is-buiquocdoanh/Temperature-and-humidity-sensor-network/Image/gate_way_sofware.png

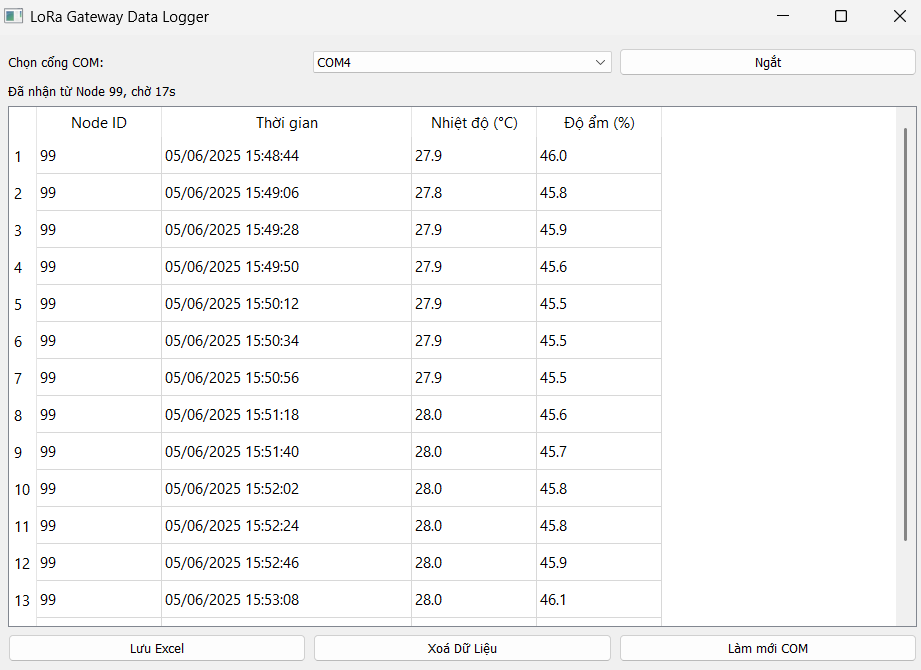
Image/gate_way_sofware.png
