is-buiquocdoanh/Temperature-and-humidity-sensor-network/Image/Hardware.jpg

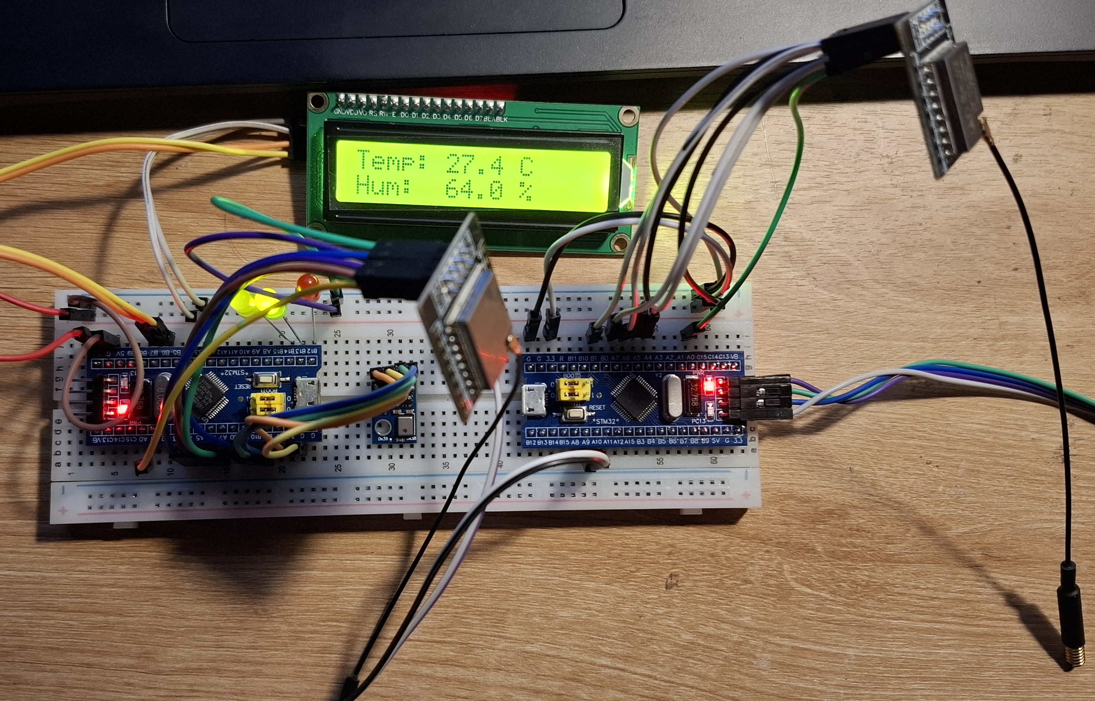
Image/Hardware.jpg
