is-buiquocdoanh/Temperature-and-humidity-sensor-network/PCB/NodeLORA/PDF/BOM NodeLORA.pdf

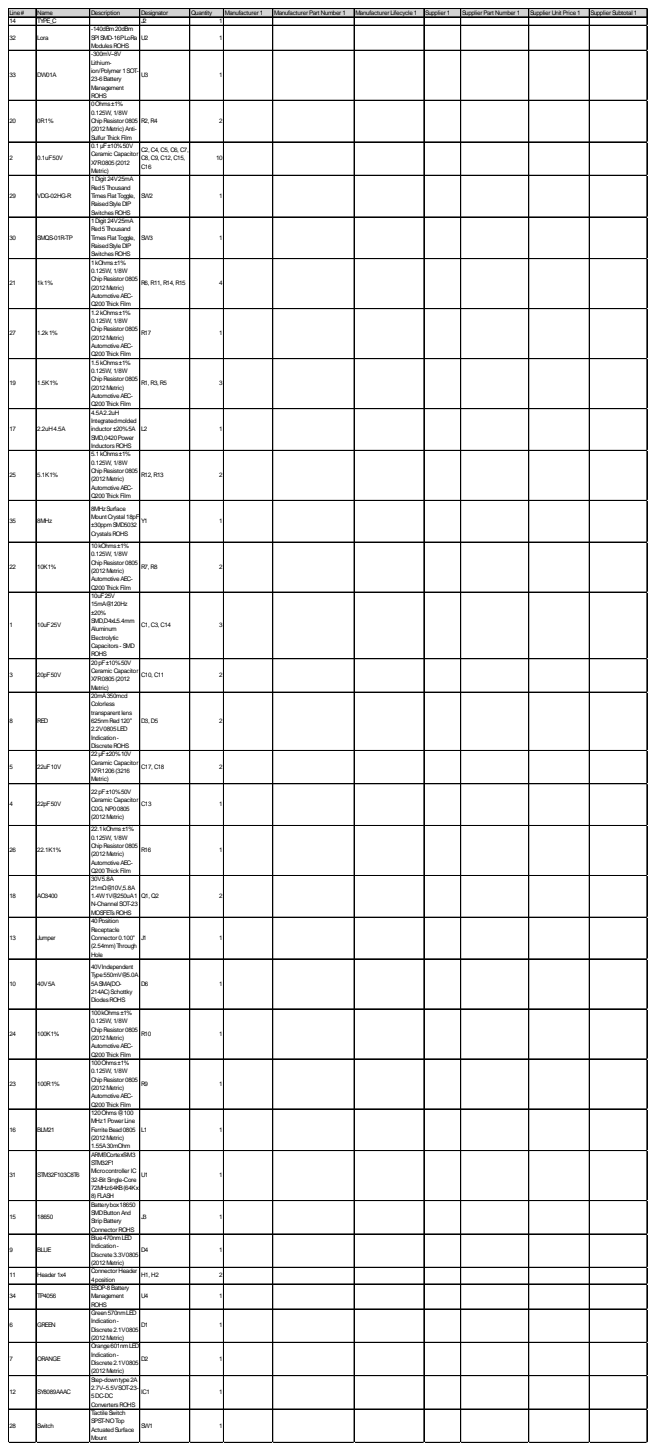
[picture p8: page 1]

32 | Lora | -140dBm20dBm SPISMD-16PLoRa ModulesROHS | U2 | | 1

33 | DW01A | -300mV~8V Lithium-ion/Polymer 1SOT-23-6Battery Management ROHS | U3 | | 1

20 | 0R1% | 0Ohms±1% 0.125W, 1/8W ChipResistor 0805 (2012Metric)Anti-Sulfur ThickFilm | R2, R4 | | 2

2 | 0.1uF50V | 0.1µF±10%50V Ceramic Capacitor X7R0805(2012 Metric) | C2, C4, C5, C6, C7, C8, C9, C12, C15, C16 | 10

29 | VDG-02HG-R | 1Digit 24V25mA Red5Thousand TimesFlat Toggle, RaisedStyleDIP SwitchesROHS | SW2 | | 1

30 | SMQS-01R-TP | 1Digit 24V25mA Red5Thousand TimesFlat Toggle, RaisedStyleDIP SwitchesROHS | SW3 | | 1

21 | 1k1% | 1kOhms±1% 0.125W, 1/8W ChipResistor 0805 (2012Metric) AutomotiveAEC-Q200ThickFilm | R6, R11, R14, R15 | | 4

27 | 1.2k1% | 1.2kOhms±1% 0.125W, 1/8W ChipResistor 0805 (2012Metric) AutomotiveAEC-Q200ThickFilm | R17 | | 1

19 | 1.5K1% | 1.5kOhms±1% 0.125W, 1/8W ChipResistor 0805 (2012Metric) AutomotiveAEC-Q200ThickFilm | R1, R3, R5 | | 3

17 | 2.2uH4.5A | 4.5A2.2uH Integratedmolded inductor ±20%5A SMD,0420Power InductorsROHS | L2 | | 1

25 | 5.1K1% | 5.1kOhms±1% 0.125W, 1/8W ChipResistor 0805 (2012Metric) AutomotiveAEC-Q200ThickFilm | R12, R13 | | 2

35 | 8MHz | 8MHzSurface Mount Crystal 18pF ±30ppmSMD5032 CrystalsROHS | Y1 | | 1

22 | 10K1% | 10kOhms±1% 0.125W, 1/8W ChipResistor 0805 (2012Metric) AutomotiveAEC-Q200ThickFilm | R7, R8 | | 2

1 | 10uF25V | 10uF25V 15mA@120Hz ±20% SMD,D4xL5.4mm Aluminum Electrolytic Capacitors - SMD ROHS | C1, C3, C14 | | 3

3 | 20pF50V | 20pF±10%50V Ceramic Capacitor X7R0805(2012 Metric) | C10, C11 | | 2

8 | RED | 20mA350mcd Colorless transparent lens 625nmRed120° 2.2V0805LED Indication-DiscreteROHS | D3, D5 | | 2

5 | 22uF10V | 22µF±20%10V Ceramic Capacitor X7R1206(3216 Metric) | C17, C18 | | 2

4 | 22pF50V | 22pF±10%50V Ceramic Capacitor C0G, NP00805 (2012Metric) | C13 | | 1

26 | 22.1K1% | 22.1kOhms±1% 0.125W, 1/8W ChipResistor 0805 (2012Metric) AutomotiveAEC-Q200ThickFilm | R16 | | 1

18 | AO3400 | 30V5.8A 21mΩ@10V,5.8A 1.4W1V@250uA1 N-Channel SOT-23 MOSFETsROHS | Q1, Q2 | | 2

13 | Jumper | 40Position Receptacle Connector 0.100" (2.54mm)Through Hole | J1 | | 1

10 | 40V5A | 40VIndependent Type550mV@5.0A 5ASMA(DO-214AC)Schottky DiodesROHS | D6 | | 1

24 | 100K1% | 100kOhms±1% 0.125W, 1/8W ChipResistor 0805 (2012Metric) AutomotiveAEC-Q200ThickFilm | R10 | | 1

23 | 100R1% | 100Ohms±1% 0.125W, 1/8W ChipResistor 0805 (2012Metric) AutomotiveAEC-Q200ThickFilm | R9 | | 1

16 | BLM21 | 120Ohms@100 MHz1Power Line FerriteBead0805 (2012Metric) 1.55A30mOhm | L1 | | 1

31 | STM32F103C8T6 | ARM®Cortex®-M3 STM32F1 Microcontroller IC 32-Bit Single-Core 72MHz64KB(64Kx 8)FLASH | U1 | | 1

15 | 18650 | Batterybox18650 SMDButtonAnd StripBattery Connector ROHS | J3 | | 1

9 | BLUE | Blue470nmLED Indication-Discrete3.3V0805 (2012Metric) | D4 | | 1

11 | Header 1x4 | Connector Header 4position | H1, H2 | | 2

34 | TP4056 | ESOP-8Battery Management ROHS | U4 | | 1

6 | GREEN | Green570nmLED Indication-Discrete2.1V0805 (2012Metric) | D1 | | 1

7 | ORANGE | Orange601nmLED Indication-Discrete2.1V0805 (2012Metric) | D2 | | 1

12 | SY8089AAAC | Step-downtype2A 2.7V~5.5VSOT-23-5DC-DC ConvertersROHS | IC1 | | 1

28 | Switch | TactileSwitch SPST-NOTop ActuatedSurface Mount | SW1 | | 1
