is-buiquocdoanh/Temperature-and-humidity-sensor-network/PCB/SCH-NodeLORA.pdf

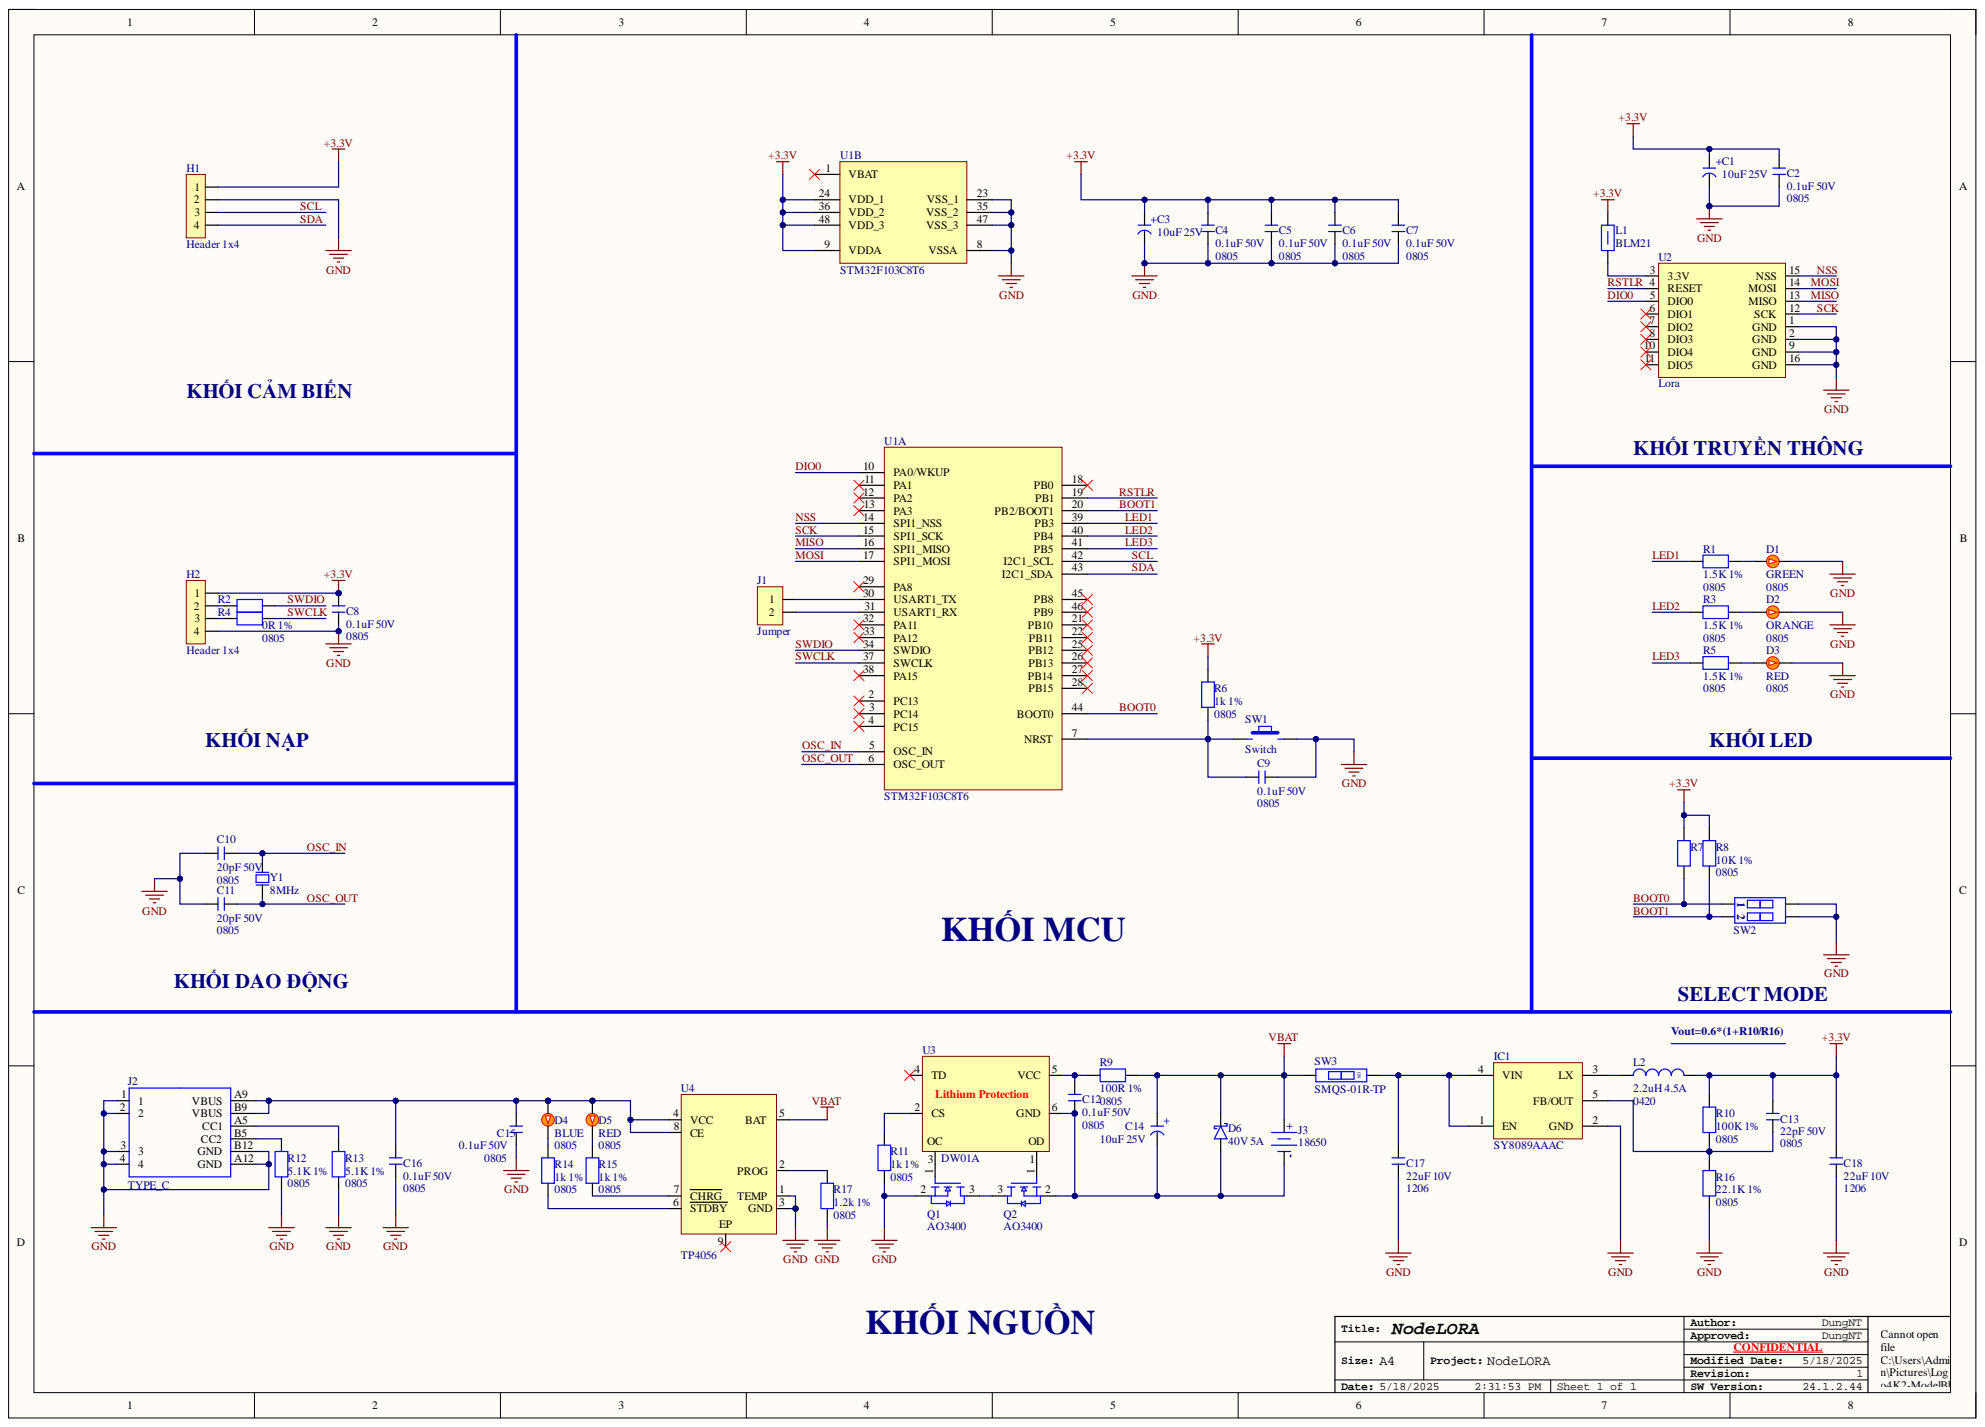
[picture p9: page 1]
