is-buiquocdoanh/Temperature-and-humidity-sensor-network/PCB/NodeLORA/PDF/PCB NodeLORA.pdf

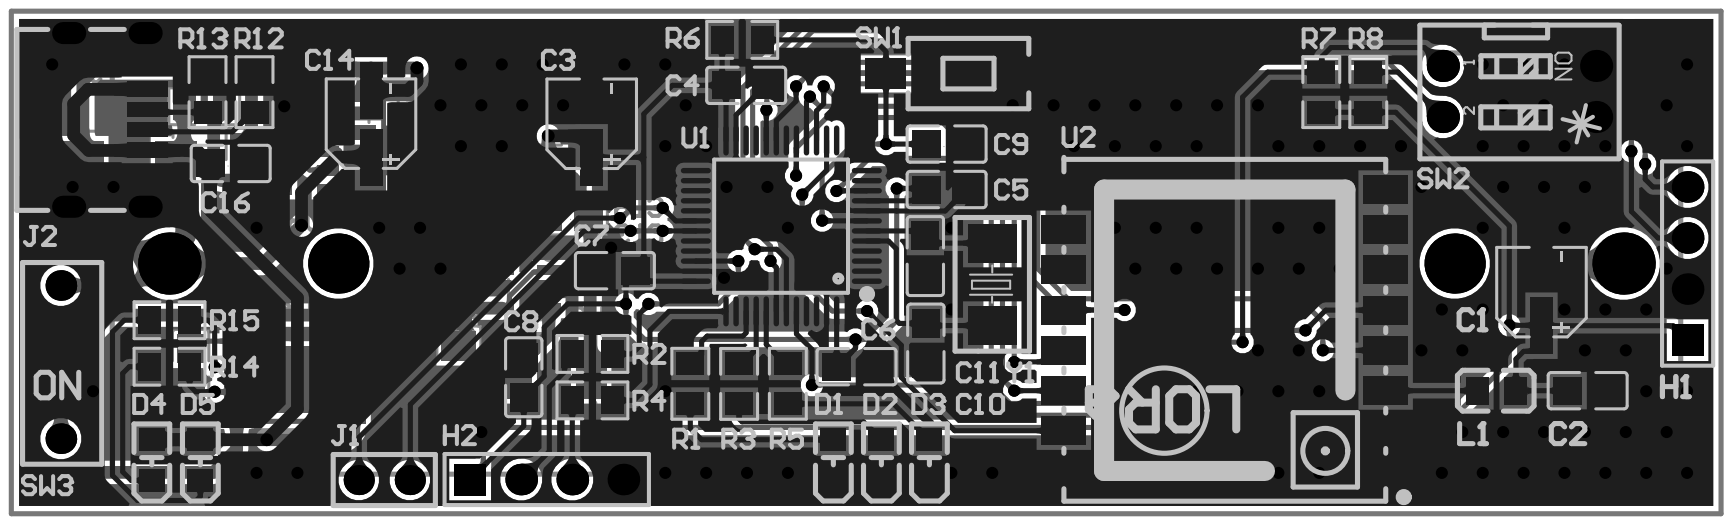
[picture p10: page 1]
