is-buiquocdoanh/Temperature-and-humidity-sensor-network/(list of files, drawings)

Other design files:
PCB/NodeLORA/NodeLORA.PrjPcb
PCB/NodeLORA/NodeLORA.SchDoc
