is-buiquocdoanh/Temperature-and-humidity-sensor-network/Node_LoRa/Core/Src/main.c

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
/* Includes ------------------------------------------------------------------*/
#include "main.h"

/* USER CODE BEGIN Includes */
#include "string.h"
#include "stdio.h"
#include "stdlib.h"
#include "i2c_lcd.h"
#include "aht10.h"
#include "LoRa.h"
/* USER CODE END Includes */

I2C_HandleTypeDef hi2c1;
I2C_HandleTypeDef hi2c2;

SPI_HandleTypeDef hspi1;

TIM_HandleTypeDef htim2;

UART_HandleTypeDef huart1;

/* USER CODE BEGIN PV */
AHT10_HandleTypeDef aht10;
I2C_LCD_HandleTypeDef lcd;

LoRa myLoRa;

char debug[32];
char buffer[32];
float temperature, humidity;
uint32_t temp_raw = 0;
uint32_t hum_raw = 0;

//Biến cấu hình ngưỡng và chu kỳ
float temp_max = 30.0;
float temp_min = 25.0;
float humi_max = 70.0;
float humi_min = 40.0;
uint32_t interval_ms = 1000;  // mặc định 1 giây

uint8_t uart_rx_buf[64];
char uart_line[64];
uint8_t uart_index = 0;

/* USER CODE END PV */

void SystemClock_Config(void);
static void MX_GPIO_Init(void);
static void MX_I2C1_Init(void);
static void MX_I2C2_Init(void);
static void MX_SPI1_Init(void);
static void MX_USART1_UART_Init(void);
static void MX_TIM2_Init(void);
/* USER CODE BEGIN PFP */

// Phân tích lệnh từ UART
void parse_uart_command(char *cmd) {
    if (strncmp(cmd, "SET:", 4) == 0) {
        char *token = strtok(cmd + 4, ":");
        while (token != NULL) {
            if (strncmp(token, "TMAX=", 5) == 0) temp_max = atof(token + 5);
            else if (strncmp(token, "TMIN=", 5) == 0) temp_min = atof(token + 5);
            else if (strncmp(token, "HMAX=", 5) == 0) humi_max = atof(token + 5);
            else if (strncmp(token, "HMIN=", 5) == 0) humi_min = atof(token + 5);
            else if (strncmp(token, "INTERVAL=", 9) == 0) interval_ms = atoi(token + 9) * 1000;
            token = strtok(NULL, ":");
        }
        HAL_UART_Transmit(&huart1, (uint8_t*)"Config Updated\r\n", 16, HAL_MAX_DELAY);
    }
}

/* Ngắt USART1 xử lý ngay trong main.c */
void HAL_UART_RxCpltCallback(UART_HandleTypeDef *huart) {
    if (huart->Instance == USART1) {
        char ch = uart_rx_buf[0];

        if (ch == '\n' || ch == '\r') {
            uart_line[uart_index] = '\0';  // kết thúc chuỗi

            HAL_UART_Transmit(&huart1, (uint8_t*)"Received: ", 10, HAL_MAX_DELAY);
            HAL_UART_Transmit(&huart1, (uint8_t*)uart_line, strlen(uart_line), HAL_MAX_DELAY);
            HAL_UART_Transmit(&huart1, (uint8_t*)"\r\n", 2, HAL_MAX_DELAY);

            parse_uart_command(uart_line);  // xử lý lệnh
            uart_index = 0;
            memset(uart_line, 0, sizeof(uart_line));
        } else {
            if (uart_index < sizeof(uart_line) - 1) {
                uart_line[uart_index++] = ch;
            }
        }

        // nhận tiếp 1 byte
        HAL_UART_Receive_IT(&huart1, uart_rx_buf, 1);
    }
}


/* USER CODE END PFP */

/**
  * @brief  The application entry point.
  * @retval int
  */
int main(void)
{

  /* MCU Configuration--------------------------------------------------------*/

  /* Reset of all peripherals, Initializes the Flash interface and the Systick. */
  HAL_Init();

  /* Configure the system clock */
  SystemClock_Config();

  /* Initialize all configured peripherals */
  MX_GPIO_Init();
  MX_I2C1_Init();
  MX_I2C2_Init();
  MX_SPI1_Init();
  MX_USART1_UART_Init();
  MX_TIM2_Init();
  /* USER CODE BEGIN 2 */

  // Bật Timer với ngắt
  HAL_TIM_Base_Start_IT(&htim2);

  //Bật receive uart
  HAL_UART_Receive_IT(&huart1, uart_rx_buf, 1);  // khởi động nhận từng byte

  //Init LCD
  lcd.hi2c = &hi2c1;
  lcd.address = 0x4E;
  lcd_init(&lcd);
  lcd_clear(&lcd);

  //Init AHT10
  aht10.hi2c = &hi2c2;
  aht10.address = 0x38<<1; //AHT10 default address << 1 = 0x38 << 1 = 0x70
  AHT10_Init(&aht10);
  HAL_Delay(50);

  //Init LoRa
  myLoRa = newLoRa();

  myLoRa.CS_port         = NSS_GPIO_Port;
  myLoRa.CS_pin          = NSS_Pin;
  myLoRa.reset_port      = RST_GPIO_Port;
  myLoRa.reset_pin       = RST_Pin;
  myLoRa.DIO0_port       = DIO0_GPIO_Port;
  myLoRa.DIO0_pin        = DIO0_Pin;
  myLoRa.hSPIx           = &hspi1;

  LoRa_init(&myLoRa);

    if (!LoRa_init(&myLoRa)) {
        HAL_UART_Transmit(&huart1, (uint8_t*)"LoRa init failed\r\n", 18, 100);
    }
    else {
    	HAL_UART_Transmit(&huart1, (uint8_t*)"LoRa init done\r\n", 14, 100);
    }

  /* USER CODE END 2 */

  /* Infinite loop */
  /* USER CODE BEGIN WHILE */
  while (1)
  {
		//Read sensor AHT10
		if (AHT10_ReadRaw(&aht10, &hum_raw, &temp_raw)) {
			temperature = AHT10_ReadTemperature(temp_raw);
			humidity = AHT10_ReadHumidity(hum_raw);

			int temp_int = (int) temperature;
			int temp_frac = (int) ((temperature - temp_int) * 10);

			int hum_int = (int) humidity;
			int hum_frac = (int) ((humidity - hum_int) * 10);

			//Send data via UART & LoRa
			uint8_t node_id = 01;
			sprintf(buffer, "NODE%d:%d.%d:%d.%d\r\n", node_id, temp_int,
					temp_frac, hum_int, hum_frac);
			HAL_UART_Transmit(&huart1, (uint8_t*) buffer, strlen(buffer),
			HAL_MAX_DELAY);

			if (!LoRa_transmit(&myLoRa, (uint8_t*) buffer, strlen(buffer),
					100)) {
				HAL_UART_Transmit(&huart1, (uint8_t*) "LoRa Send Error\r\n", 17,
				HAL_MAX_DELAY);
			}

			// LED theo nhiệt độ
			HAL_GPIO_WritePin(GPIOB, GPIO_PIN_12, GPIO_PIN_RESET);
			HAL_GPIO_WritePin(GPIOB, GPIO_PIN_13, GPIO_PIN_RESET);
			HAL_GPIO_WritePin(GPIOB, GPIO_PIN_14, GPIO_PIN_RESET);

			GPIO_TypeDef *ledPort = GPIOB;
			uint16_t ledPin;
			if (temperature > temp_max) {
				ledPin = GPIO_PIN_12; // đỏ
			} else if (temperature >= temp_min) {
				ledPin = GPIO_PIN_13; // vàng
			} else {
				ledPin = GPIO_PIN_14; // xanh
			}

			uint32_t displayTime = 2000;
			uint32_t startTime = HAL_GetTick();
			while ((HAL_GetTick() - startTime) < displayTime) {
				if (humidity >= humi_min && humidity <= humi_max) {
					HAL_GPIO_WritePin(ledPort, ledPin, GPIO_PIN_SET);
				} else if (humidity < humi_min) {
					HAL_GPIO_WritePin(ledPort, ledPin, GPIO_PIN_SET);
					HAL_Delay(100);
					HAL_GPIO_WritePin(ledPort, ledPin, GPIO_PIN_RESET);
					HAL_Delay(100);
				} else {
					HAL_GPIO_WritePin(ledPort, ledPin, GPIO_PIN_SET);
					HAL_Delay(500);
					HAL_GPIO_WritePin(ledPort, ledPin, GPIO_PIN_RESET);
					HAL_Delay(500);
				}
			}

			//Display on LCD
			sprintf(buffer, "Temp: %d.%d C", temp_int, temp_frac);
			lcd_gotoxy(&lcd, 0, 0);
			lcd_puts(&lcd, buffer);

			sprintf(buffer, "Hum:  %d.%d %%", hum_int, hum_frac);
			lcd_gotoxy(&lcd, 0, 1);
			lcd_puts(&lcd, buffer);
		} else {
			lcd_gotoxy(&lcd, 0, 0);
			HAL_UART_Transmit(&huart1, (uint8_t*) "AHT10 Error\r\n", 13,
					HAL_MAX_DELAY);
		}

		// Delay theo chu kỳ
		HAL_Delay(interval_ms);

//	  // ---- CHẾ ĐỘ SLEEP ----
//	  HAL_SuspendTick();  // Ngừng SysTick để không tự wake up
//	  HAL_PWR_EnterSLEEPMode(PWR_MAINREGULATOR_ON, PWR_SLEEPENTRY_WFI);
//	  HAL_ResumeTick();   // Khi wake up xong, bật lại SysTick;


    /* USER CODE END WHILE */

    /* USER CODE BEGIN 3 */
  }
  /* USER CODE END 3 */
}

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
