is-buiquocdoanh/Temperature-and-humidity-sensor-network/Node_LoRa/Core/Inc/main.h

#define DIO0_Pin GPIO_PIN_0
#define DIO0_GPIO_Port GPIOA
#define NSS_Pin GPIO_PIN_4
#define NSS_GPIO_Port GPIOA
#define RST_Pin GPIO_PIN_1
#define RST_GPIO_Port GPIOB
#define LED1_Pin GPIO_PIN_12
#define LED1_GPIO_Port GPIOB
#define LED2_Pin GPIO_PIN_13
#define LED2_GPIO_Port GPIOB
#define LED3_Pin GPIO_PIN_14
#define LED3_GPIO_Port GPIOB
