is-buiquocdoanh/Temperature-and-humidity-sensor-network/(commit log)

2025-06-12 fist commit
    [OCP_values.xlsx]
2025-06-22 edit file sofware
    [demo.xlsx, demo1.xlsx]
