is-buiquocdoanh/Temperature-and-humidity-sensor-network/(notices)

Notices in the files:
Node_LoRa/Core/Inc/main.h:
Copyright (c) 2025 STMicroelectronics.
All rights reserved.
This software is licensed under terms that can be found in the LICENSE file
